MIYUPPIE/STT/(commit log)

2026-07-16 Add Yoruba voice control of ESP32-S3 servo (services/servo + firmware)
    New services/servo: Yoruba caption -> servo intent -> ESP32 over HTTP.
    Latent/deterministic split — offline rule matcher (vocab.py) handles
    left/right/center/stop/angle free and instant; Grok fallback (intent.py)
    handles open/close and unusual phrasing, returning a tiny JSON intent.
    ServoClient owns angle state, resolves relative/absolute moves, clamps,
    and drives GET /servo?angle=N. 36 gate tests (no network) + a paid eval.
    firmware/esp32s3_servo: adds a /servo PWM endpoint to the camera+LED
    server on its own LEDC timer 1 / channel 2 @ 50 Hz (no collision with the
    camera XCLK on timer 0 / channel 0), servo on GPIO 14,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
    [config.py, contract.py, controller.py, esp32s3_servo.ino, intent.py, live_caption.py]
2026-07-30 Add Yoruba voice control of a 2-wheel robot over USB (services/robot + firmware)
    The laptop is the server this time: the ESP32-S3 is on USB and drives a dual
    H-bridge (IN1-4 -> GPIO 4/5/6/7, two DC motors). Voice in -> serial command
    out -> robot moves -> spoken Yoruba reply back.
    services/robot: Yoruba caption -> movement intent -> serial link.
    forward/backward/left/right/stop + fast/slow speed words, free and offline;
    Grok fallback (intent.py) handles negations/paraphrases, returning a tiny
    JSON intent. RobotLink frames wire commands (F,speed,ms / S / P) over an
    injectable serial transport and classifies ACKs. Each exe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
2026-07-30 Fix robot firmware build on ESP32 core 3.x: use ledcAttach/ledcWrite
    analogWriteResolution is per-pin in core 3.3.7 (analogWriteResolution(pin,
    bits)), so the single-arg call failed to compile. Switch motor PWM to the
    LEDC API (ledcAttach(pin,freq,res) + ledcWrite(pin,duty)) — the unambiguous
    core 3.x way, verified against the installed esp32-hal-ledc.h signatures.
    [esp32s3_robot.ino]
2026-07-30 Doc: robot Serial routing depends on which USB port (UART bridge vs native)
    The board connects via a CH343 UART bridge (ttyACM0, VID 1A86), not the S3
    native USB. With that cable, USB CDC On Boot must be DISABLED so Arduino
    Serial = UART0; with it Enabled, Serial goes to the native USB port and the
    bridge sees nothing (port opens but 'no ack from board'). Fix the misleading
    'Enabled' note in firmware + README.
    [esp32s3_robot.ino]
2026-07-30 L298N: drop input PWM to 1 kHz + document ENA/ENB enable requirement
    Board ACKed OK but motors didn't move: ENA/ENB enable jumpers were removed
    (L298N outputs disabled), and 20 kHz input PWM is too fast for the L298N
    bipolar transistors. Lower PWM_FREQ to 1000 and document that ENA/ENB must
    be enabled. MOSFET drivers can still use 20 kHz.
    [esp32s3_robot.ino]
2026-07-30 Add continuous drive: `--hold` keepalive mode for the robot
    `python -m services.robot.controller --hold "<command>"` drives continuously
    in the parsed direction, resending a HOLD_MS move every HOLD_REFRESH seconds so
    the board's move-window never lapses, and always stops on Ctrl+C (or via the
    firmware watchdog within ~2 s if the process is killed). No reflash needed.
    5 new gate tests cover resend + guaranteed stop, stop-word, non-command, board
    not open, and board-error halt. Verified on real hardware.
    [config.py, controller.py]
2026-07-30 live_caption: auto-fall back to CPU when GPU CUDA libs can't load
    Whisper defaulted to cuda/float16 and hard-crashed with "libcublas.so.12 not
    found" when launched from a shell whose library path lacks the CUDA libs
    (they only live in the tf_gpu env / ollama bundle here, not on the default
    path). Wrap the load+warmup: on a cuda failure, print the reason and retry on
    cpu/int8 instead of crashing. Grok + TTS are cloud, so CPU is fine for control.
    Verified on-machine: reproduced the real GPU failure and the CPU recovery.
    [live_caption.py]
2026-07-30 live_caption: capture at a mic-supported rate and resample to 16 kHz
    The mic (ALC257 analog codec) rejects a 16 kHz ALSA capture rate, so opening
    the InputStream crashed with paInvalidSampleRate. Auto-pick a rate the device
    accepts (prefer integer ratios: 48k -> /3), open there, and resample each block
    to exactly WINDOW samples at 16 kHz for the VAD + Whisper (scipy resample_poly).
    MIC_DEVICE env overrides the input device. Verified on the real mic: opens at
    48 kHz, 1536-sample blocks resample to 512.
    [live_caption.py]
2026-07-30 live_caption: turn-based mic in robot mode (finish a command before hearing the next)
    Previously the mic kept capturing while the current command was still decoding/
    moving/replying, so a new utterance stepped on the one in flight. Add a `busy`
    gate for the whole command turn: the segmenter sets it at end-of-speech, and the
    mic ignores input until the turn ends — when the robot's spoken reply finishes
    (tts_play_worker), or immediately for a non-command / no-reply / empty decode.
    In robot mode the robot now owns the turn, so the refiner no longer double-speaks
    over the robot's confirmation. Non-robot modes are unchanged (command_mode unset).
    Verified with the real threads + fakes: mic gates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
    [live_caption.py]
2026-07-31 Fix mic overflow (dropped audio -> garbled STT) + match split-word commands
    Root cause of "robot not working": constant PortAudio input overflow dropped
    mic audio, so Whisper heard garbage ("síwájú" -> "sí bá jù") and nothing matched
    a command. Fixes:
    - Capture in large blocks (~256 ms, 8 VAD windows) with a 0.4 s buffer so a CPU
    spike (Whisper decoding) can't overflow the mic. Verified: 0 overflows under a
    4x CPU burn that previously dropped ~15% of callbacks.
    - Keep the realtime callback trivial; resample 48k->16k and slice into 512-sample
    windows in the segmenter (stateful buffer), not in the audio callback.
    - Silence the non-fatal input_overflow status spam.
    - Robot vocab: ma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
    [live_caption.py, vocab.py]
2026-07-31 Robot voice: continuous latched drive + instant cached replies
    Two UX fixes for --robot: (1) movement is now continuous — a direction command
    latches (controller.drive) and the robot keeps moving until another command or
    "dúró" (controller.halt), driven by a thread-safe keepalive that resends the
    move every HOLD_REFRESH (firmware watchdog still halts within ~2s if the process
    dies). (2) The spoken reply was slow because every command hit YarnGPT; the five
    confirmations are fixed, so they're synthesized once at startup and replayed from
    cache (enqueue_audio bypasses synth) — instant. robot_thread rewritten around
    drive/halt + cached clips; robot halted on exit. 3 new gate tests for driv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
    [controller.py, live_caption.py]
2026-07-31 Robot vocab: match split left/right/stop ("ó sí" = òsì, "dú ró" = dúró)
    Whisper splits short command words too, so "òsì" -> "ó sí", "ọ̀tún" -> "ó tún",
    "dúró" -> "dú ró" never formed the whole token and missed. Despace-match these
    like forward/backward; the negation guard ("kò"/"má") already keeps "kò sí"
    (there isn't) from turning left. +3 gate cases.
    [vocab.py]
2026-07-31 Robot: fuzzy autocorrect command matching (tolerate Whisper mishearings)
    Whisper mangles commands ("dúró"->"dulo", "ọ̀tún"->"ko tun", "síwájú"->"wájìn"/
    "síwád yìn", "òsì"->"ó sí") and hardcoding every variant doesn't scale. Replace
    the exact-token matcher with fuzzy autocorrect: normalize, generate token n-grams,
    edit-distance-match (difflib) against a small canonical lexicon (real word + common
    mishearings) and take the best above ROBOT_MATCH_THRESHOLD (0.72). Negation forms
    ("kò sí") map to a NONE marker so they never turn left; a "má" negation routes to
    Grok; STOP always wins. Validated 26/26 on real session transcripts with no
    over-matching of greetings; +3 gate tes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
    [config.py, vocab.py]
2026-10-08 Robot over WiFi + N-ATLAS Yoruba STT (offline, no new download)
    WiFi robot link:
    - firmware/esp32s3_robot: TCP server :3333 + mDNS yoruba-robot.local,
    same line protocol as USB (which still works). Stops motors on client
    disconnect, WiFi loss, new client, and the existing 2 s watchdog. WiFi
    sleep off for ms latency. Credentials in git-ignored secrets.h.
    - services/robot/link.py: TcpTransport (persistent, NODELAY, reconnect
    once + retry, throttled while robot is off); discovery = ROBOT_HOST ->
    mDNS (killable getent) -> outbound /24 PONG sweep (firewall-proof).
    ROBOT_LINK=auto tries WiFi then USB.
    - services/robot/sim.py: firmware stand-in for tests and bench runs.
    N-ATLAS STT:
    -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
2026-10-08 Robot: L298N speed control on ENA/ENB (GPIO 41/42, ESP32-S3)
    - IN1-4 (GPIO 4-7) are now plain direction lines; speed is 1 kHz LEDC PWM
    on ENA=GPIO 41 / ENB=GPIO 42 (free on Freenove/DevKitC-1 S3 boards: not
    strapping, USB, UART0, octal PSRAM, camera bus or onboard LEDs).
    - motor_math.h (pure, host-tested): speed 1..255 -> MIN_DUTY..255 so slow
    commands still turn the wheels; per-wheel trim; 150 ms ramp that passes
    reversals through 0 and skips the stall dead zone. Stops stay instant.
    - tests: host g++ suite for motor_math + sketch wiring guard
    (services/robot/tests/test_firmware.py).
    - sim.close(): shut the listener down before dropping the client; fixes a
    race that made test_rob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
    [esp32s3_robot.ino, motor_math.h, sim.py, test_motor_math.cpp]
2026-10-09 ROS2: /cmd_vel digital twin — real ESP32 + Gazebo + RViz on one voice
    New package `yoruba_robot` under services/ros2/ (symlinked into ~/ros2_ws/src):
    - robot_bridge: subscribes /cmd_vel, converts Twist->F/B/L/R via
    kinematics.twist_to_command, pushes to the ESP32 via the existing
    services.robot.link.TcpTransport (WiFi) with keepalive + cmd_vel timeout
    auto-stop. Publishes /odom + odom->base_link TF from dead reckoning
    (exact arc integration; a long spin-in-place doesn't linearly drift).
    - voice_relay: localhost TCP :7447 line listener; each F,200/S line becomes
    a /cmd_vel Twist. Bridges conda py3.13 (STT) to system py3.12 (rclpy).
    - kinematics.py: pure math, host-tested (18 tests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
    [empty.sdf, robot.urdf.xacro]
2026-10-09 ros2: wrap xacro Command in ParameterValue(..., value_type=str)
    Jazzy's launch_ros tries to YAML-parse robot_description if it isn't marked as a
    string; the URDF XML trips that and the launch fails with 'Unable to parse the
    value of parameter robot_description as yaml.' Fix: wrap the xacro Command in
    ParameterValue with value_type=str, in all three launch files.
2026-10-09 ros2: switch Gazebo render engine from ogre2 to ogre1
    Observed on this machine (RTX 2060 / NVIDIA 580.119.02 / Ubuntu Noble):
    gz-sim 8 Ogre2 segfaults inside Hlms::createDatablock while parsing
    material scripts at startup. Ogre1 (libgz-rendering8-ogre.so) is already
    installed as an alternate plugin and starts cleanly.
    - worlds/empty.sdf: sensors plugin now <render_engine>ogre</render_engine>.
    - sim.launch.py and twin.launch.py: pass --render-engine-gui ogre to gz_sim.
    Fallback plan if the crash reoccurs on another box: 'LIBGL_ALWAYS_SOFTWARE=1
    ros2 launch yoruba_robot sim.launch.py' forces mesa software rendering.
    [empty.sdf]
2026-10-09 ros2: Gazebo client GUI off by default (gui:=true opt-in)
    Gazebo 8's Ogre renderer (both ogre2 and ogre1) segfaults during startup
    on this box's NVIDIA 580 / RTX 2060 / Ubuntu Noble combo. The physics
    server, DiffDrive plugin, parameter bridges, /sim_odom, /cmd_vel, /tf
    and RViz all work fine without the Gazebo window — RViz is the visualiser
    either way.
    sim.launch.py and twin.launch.py: default gz_args to '-r -s -v 2 world'
    (server only). Pass gui:=true to also start the Gazebo client when the
    machine supports it.
    Verified headless: twin.launch.py brought up all 10 expected topics,
    Gazebo physics server stayed alive, 402 /sim_odom samples captured after
    publishing /cmd_vel; sim robot mo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
2026-10-09 ros2: robot_bridge publishes TF to base_footprint (URDF root)
    The URDF root is base_footprint, with base_link as a child via a fixed
    joint (base_footprint sits on the ground, base_link at the wheel axle).
    robot_state_publisher publishes base_footprint → base_link as /tf_static.
    If robot_bridge also parented base_link from odom (its old default), the
    model had two TF parents and RViz rendered 'No transform' with the whole
    tree marked red.
    Fix: default base_frame param to 'base_footprint'. One parent per frame;
    odom → base_footprint → base_link → wheels resolves clean.
    Verified end to end: tf2_echo odom base_footprint moved from (1.732, 0)
    to (1.807, 0) across one second of /cmd_vel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
2026-10-09 ros2: readable robot model + zoomed RViz config
    URDF changes (reads as a wheeled robot in RViz now):
    - Materials defined ONCE at robot scope (RViz2 drops colours when the same
    material name is redefined per link).
    - Slightly bigger chassis (0.20 x 0.14 x 0.07 m), thicker wheels (28 mm),
    bigger caster (18 mm) so the geometry is unambiguous at close range.
    - Two-tone body: blue chassis + dark blue lid plate.
    - A red front marker on the +X face. The robot no longer looks symmetric,
    so yaw is readable at a glance when it drives.
    - A grey rim disc on the outer face of each wheel, so wheel rotation is
    visible (a plain black cylinder looks static while it spins).
    - Wheels aligned flush with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
    [robot.urdf.xacro]
2026-10-09 ros2: flat-chassis 2WD robot model, arena environment, faithful twin, tutorial
    Robot model (description/robot.urdf.xacro), built to the real part sizes:
    flat acrylic plate, two TT gear motors + 65 mm wheels (r = 0.0325, back in
    line with robot_bridge), rear ball caster touching the ground, 2x18650
    holder, L298N on brass standoffs, ESP32-S3 with forward camera. Global
    materials, inertia on every physics part, spoked rims so rotation shows.
    `prefix` arg draws a sim_ copy in the same TF tree.
    Environment: yoruba_robot/arena.py defines a 3 x 3 m walled arena with 3
    obstacles once. It generates worlds/arena.sdf (Gazebo) and
    environment_publisher draws the same thing in RViz (latched MarkerArray)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
    [arena.sdf, empty.sdf, robot.urdf.xacro]
2026-10-09 Robot: RViz/Gazebo follow the REAL motors via firmware telemetry
    The RViz "real robot" was dead reckoning from robot_bridge's own commands,
    so it diverged whenever anything else drove the robot (live_caption --robot,
    USB, scripts) or the firmware stopped it (watchdog, auto-stop, WiFi loss).
    Firmware (esp32s3_robot.ino):
    - UDP 3334 telemetry: clients send "SUB"; the robot streams
    "T,seq,ms,dutyL,dutyR,minDuty" (signed applied PWM after ramp/trim) at
    20 Hz for 3 s per SUB, up to 4 listeners. Formatter is host-tested
    (motor::formatTelemetry).
    - ArduinoOTA: re-flash over WiFi after one USB upload (OTA_PASSWORD in
    secrets.h); motors stop on OTA start. Compiles at 72% flash.
    Laptop:
    - se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
2026-10-09 ros2: fix Gazebo spawn hang from orphaned servers; clean Ctrl+C
    Symptom: `[ros_gz_sim]: Requesting list of world names.` every 5 s, robot
    never spawned. Cause: a `gz sim` server from an earlier launch (18:35,
    re-parented to init) was still running the same world on the default
    Gazebo network, so `create`'s world query collided with two servers.
    Root cause of the orphan: ros2 launch signals the `sh -c ruby gz sim`
    wrapper, which exits without passing the signal on; the server survives.
    Reproduced: Ctrl+C on a launch left its server running.
    Fix (launch_common.gazebo):
    - every launch runs on its own GZ_PARTITION (yoruba_<launch pid)>, so a
    stray server can never answer another launch's spaw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
